graysonriffe/slapdaq-board/README.md

# SlapDAQ Board

This is the KiCad project for the SlapDAQ PCB.
