graysonriffe/slapdaq-board/models/DO3316P.STEP

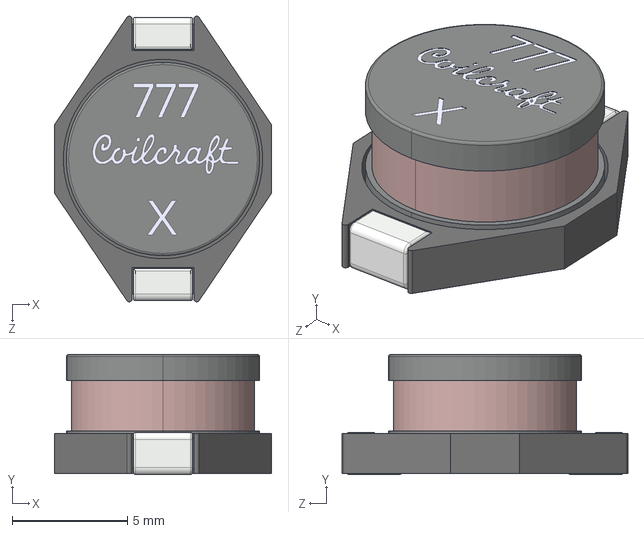
[picture p1: CAD file, 2026-09-25]
models/DO3316P.STEP
9.40 x 5.21 x 12.4 mm
