graysonriffe/slapdaq-board/models/USB4110-GF-A.stp

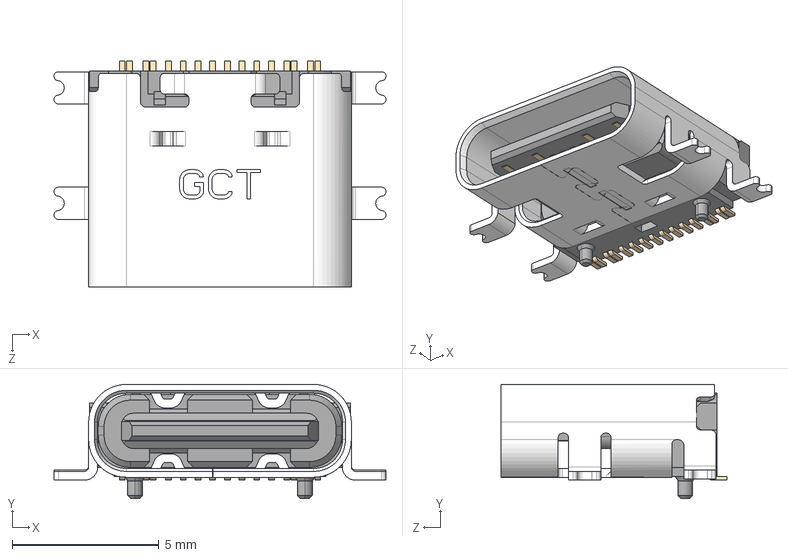
[picture p2: CAD file, 2026-09-25]
models/USB4110-GF-A.stp
11.3 x 3.89 x 7.70 mm
