graysonriffe/slapdaq-board/models/594D_C-case.stp

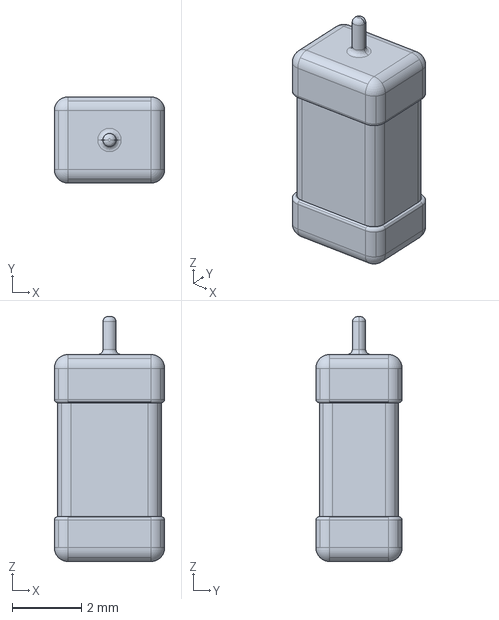
[picture p3: CAD file, 2026-09-25]
models/594D_C-case.stp
3.20 x 2.50 x 7.10 mm
