graysonriffe/slapdaq-board/models/594D_R-case.stp

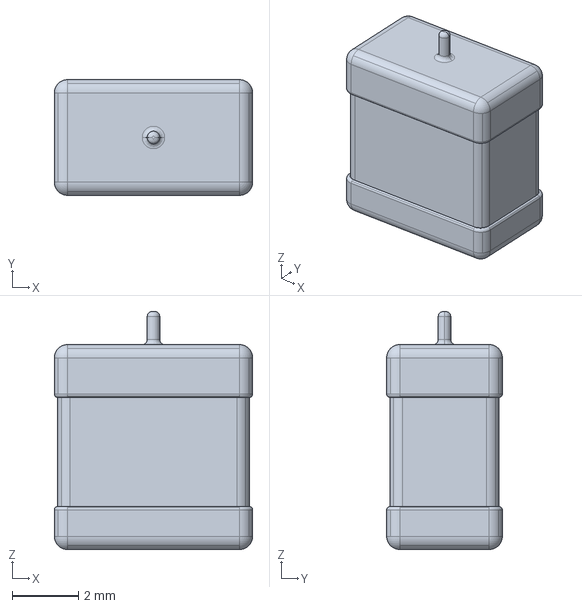
[picture p4: CAD file, 2026-09-25]
models/594D_R-case.stp
6.00 x 3.50 x 7.20 mm
