graysonriffe/slapdaq-board/models/395126010.stp

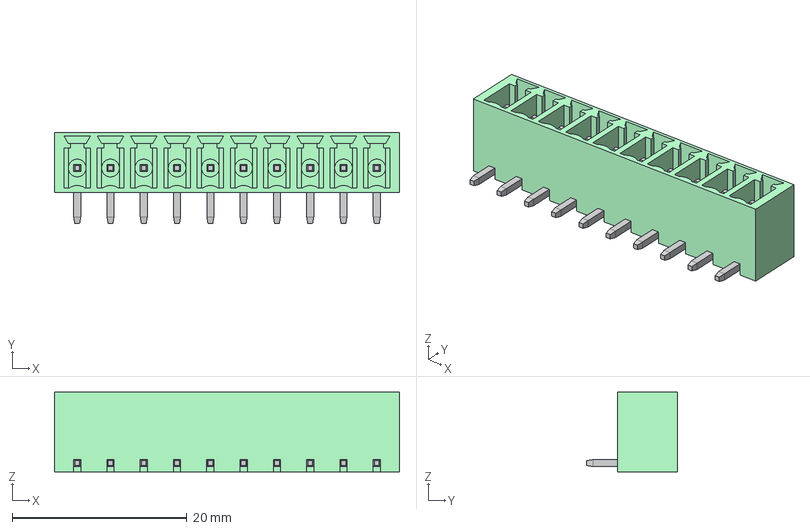
[picture p5: CAD file, 2026-09-25]
models/395126010.stp
39.5 x 10.4 x 9.14 mm
