graysonriffe/slapdaq-board/models/395105010.stp

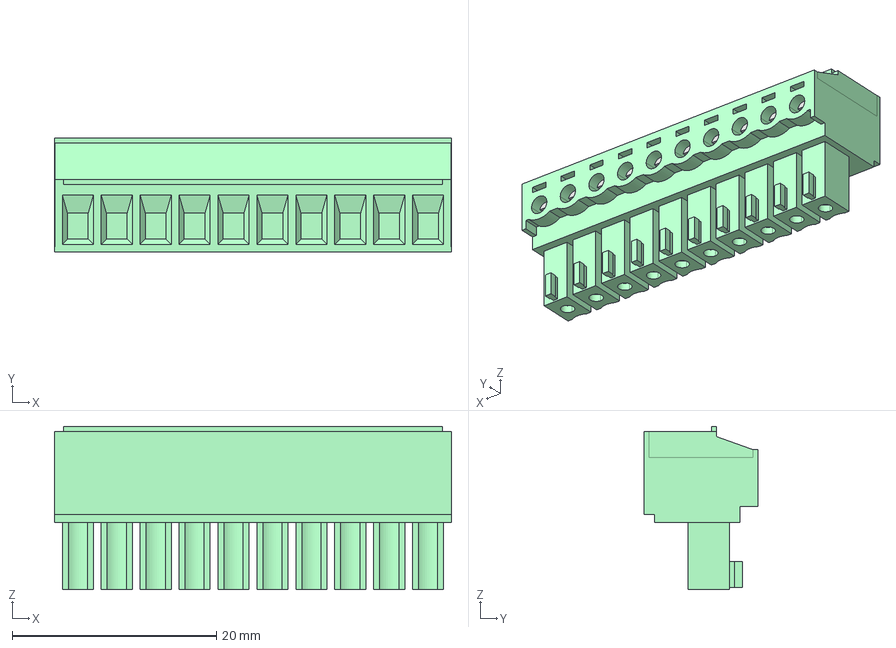
[picture p6: CAD file, 2026-09-25]
models/395105010.stp
38.9 x 11.2 x 16.0 mm
