graysonriffe/slapdaq-board/slapdaq-board.kicad_pcb

## KiCad design slapdaq-board.kicad_pcb (2026-10-12)

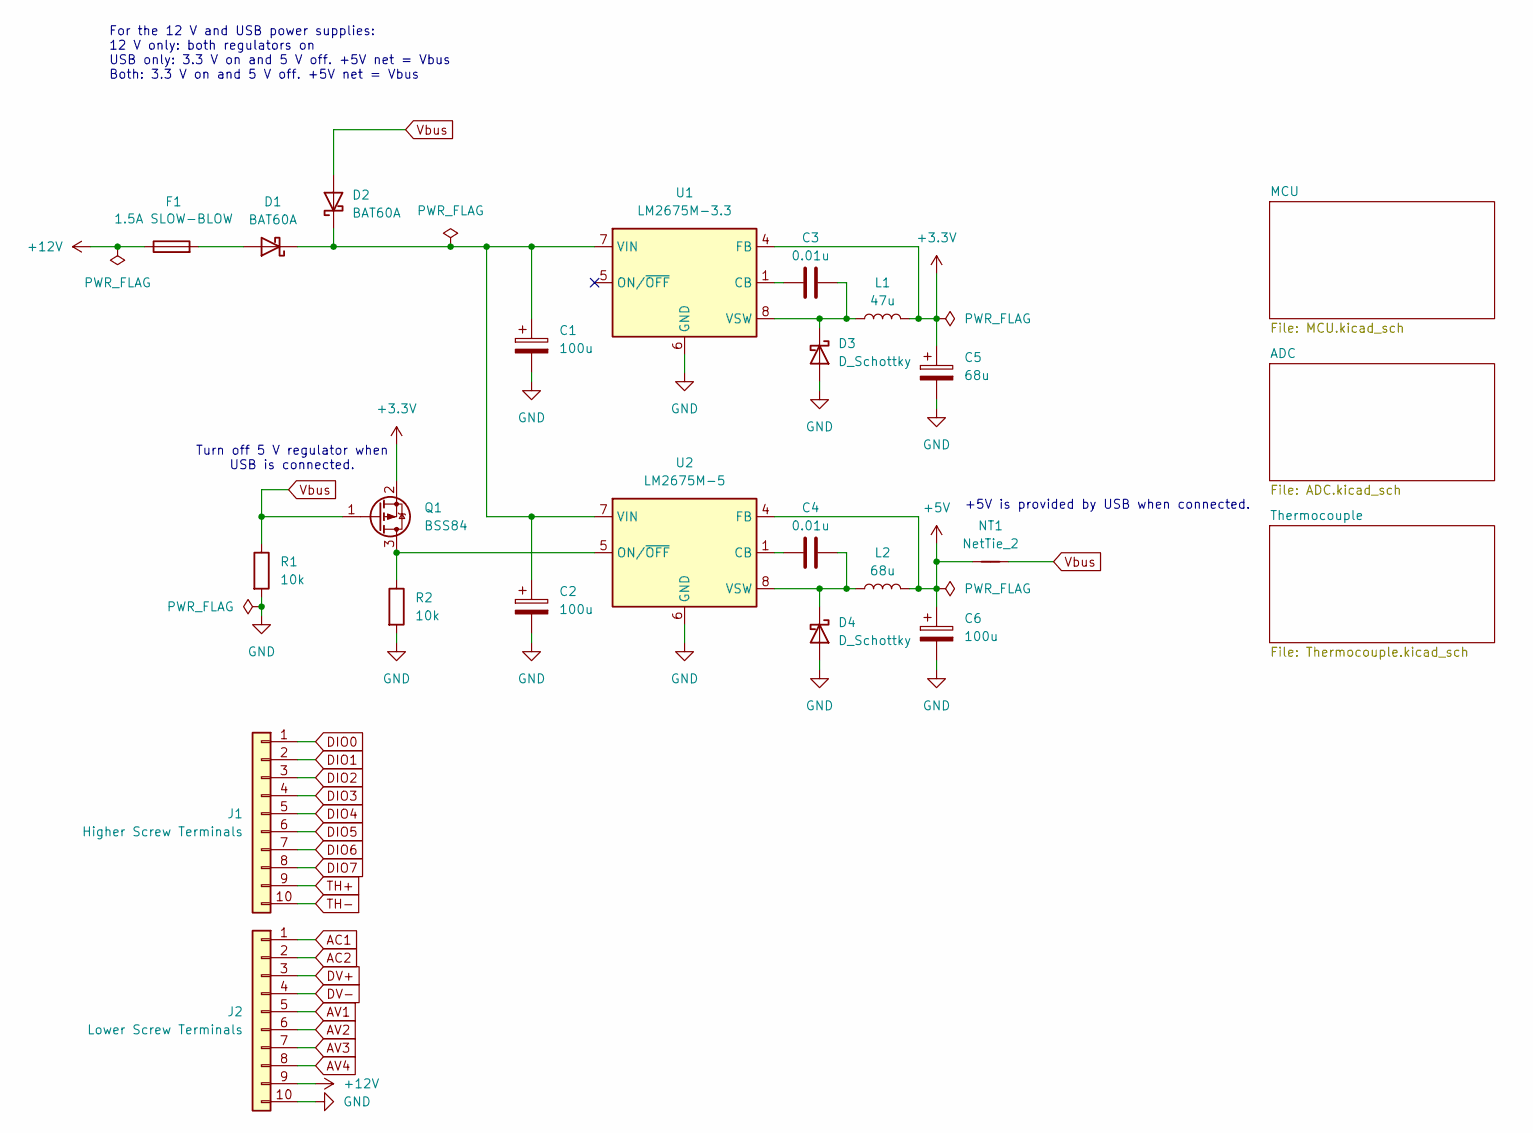
[picture p7: schematic slapdaq-board.kicad_sch, SlapDAQ - Power]

Parts:
C1, C2: 100u; CP_EIA-7260-38_AVX-R_HandSolder; MPN 594D107X9025R2T
C3, C4: 0.01u; C_1206_3216Metric_Pad1.33x1.80mm_HandSolder; MPN GRM31CR73A103KW03L
C5: 68u; CP_EIA-7132-28_AVX-C_HandSolder; MPN 594D686X9010C2T
C6: 100u; CP_EIA-7132-28_AVX-C_HandSolder; MPN 594D107X9016C2T
D1, D2: BAT60A; D_SOD-323; MPN BAT60AE6327HTSA1
D3, D4: D_Schottky; D_SMA_Handsoldering; MPN SK13
F1: 1.5A SLOW-BLOW; Fuse_1206_3216Metric_Pad1.42x1.75mm_HandSolder; MPN SF-1206S150M-2
J1: Higher Screw Terminals; CONN_SD-39512-001_10P_MOL; MPN 39512-6010
J2: Lower Screw Terminals; CONN_SD-39512-001_10P_MOL; MPN 39512-6010
L1: 47u; L_Fastron_PISN_Handsoldering; MPN DO3316P-473MLD
L2: 68u; L_Fastron_PISN_Handsoldering; MPN DO3316P-683MLD
NT1: NetTie_2; NetTie-2_SMD_Pad0.5mm
Q1: BSS84; SOT-23; MPN BSS84AK,215
R1, R2: 10k; R_1206_3216Metric_Pad1.30x1.75mm_HandSolder; MPN RC1206DR-0710KL
U1: LM2675M-3.3; SOIC-8_3.9x4.9mm_P1.27mm; MPN LM2675MX-3.3/NOPB
U2: LM2675M-5; SOIC-8_3.9x4.9mm_P1.27mm; MPN LM2675MX-5.0/NOPB

Connections:
+3.3V: C5.1, L1.2, Q1.2 (S), U1.4 (FB); also elsewhere on the board
+5V: C6.1, L2.2, NT1.1, U2.4 (FB); also elsewhere on the board
+12V: F1.1, J2.9
AC1: J2.1; also elsewhere on the board
AC2: J2.2; also elsewhere on the board
AV1: J2.5; also elsewhere on the board
AV2: J2.6; also elsewhere on the board
AV3: J2.7; also elsewhere on the board
AV4: J2.8; also elsewhere on the board
DIO0: J1.1; also elsewhere on the board
DIO1: J1.2; also elsewhere on the board
DIO2: J1.3; also elsewhere on the board
DIO3: J1.4; also elsewhere on the board
DIO4: J1.5; also elsewhere on the board
DIO5: J1.6; also elsewhere on the board
DIO6: J1.7; also elsewhere on the board
DIO7: J1.8; also elsewhere on the board
DV+: J2.3; also elsewhere on the board
DV-: J2.4; also elsewhere on the board
GND: C1.2, C2.2, C5.2, C6.2, D3.2 (A), D4.2 (A), J2.10, R1.2, R2.2, U1.6 (GND), U2.6 (GND); also elsewhere on the board
unnamed: D1.2 (A), F1.2
unnamed: C1.1, C2.1, D1.1 (K), D2.1 (K), U1.7 (VIN), U2.7 (VIN)
unnamed: C3.2, D3.1 (K), L1.1, U1.8 (VSW)
unnamed: C4.2, D4.1 (K), L2.1, U2.8 (VSW)
unnamed: Q1.3 (D), R2.1, U2.5 (ON/~OFF)
unnamed: C3.1, U1.1 (CB)
unnamed: C4.1, U2.1 (CB)
TH+: J1.9; also elsewhere on the board
TH-: J1.10; also elsewhere on the board
Vbus: D2.2 (A), NT1.2, Q1.1 (G), R1.1; also elsewhere on the board

Notes on the sheet:
Turn off 5 V regulator when USB is connected.
For the 12 V and USB power supplies: 12 V only: both regulators on USB only: 3.3 V on and 5 V off. +5V net = Vbus Both: 3.3 V on and 5 V off. +5V net = Vbus
+5V is provided by USB when connected.

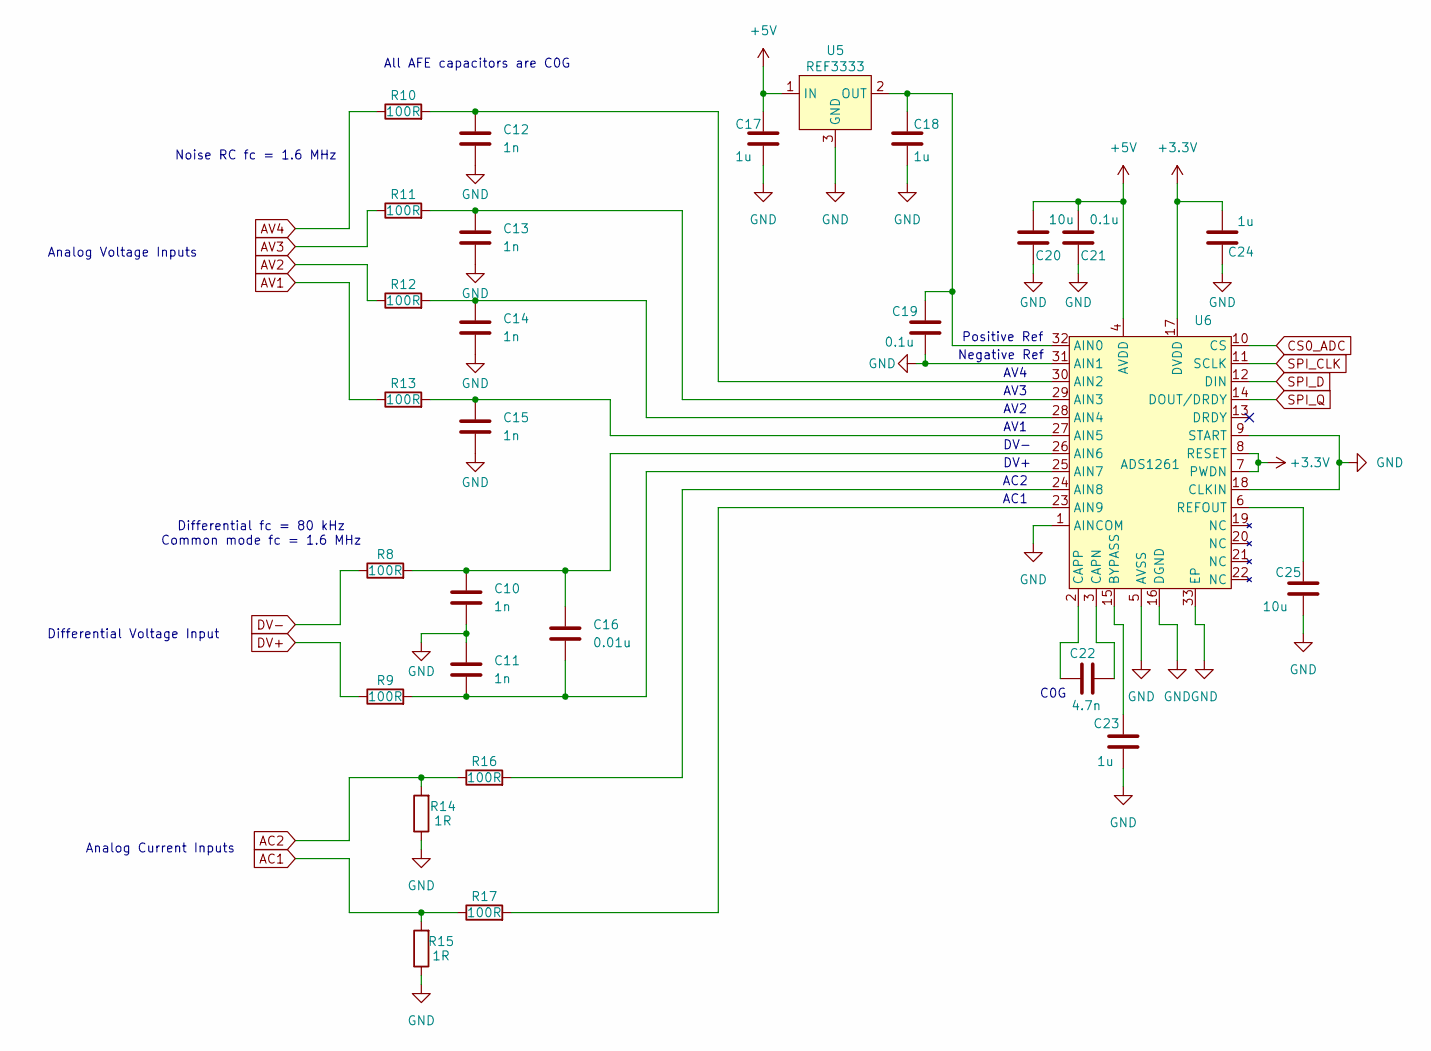
[picture p8: schematic ADC.kicad_sch, SlapDAQ - MCU]

Parts:
C10, C11, C12, C13, C14, C15: 1n; C_1206_3216Metric_Pad1.33x1.80mm_HandSolder; MPN GRM31C5C3A102JWA3L
C16: 0.01u; C_1206_3216Metric_Pad1.33x1.80mm_HandSolder; MPN GRM31C5C2J103JWA3L
C17, C18, C23, C24: 1u; C_1206_3216Metric_Pad1.33x1.80mm_HandSolder; MPN GRM31CR71E105KA01L
C19, C21: 0.1u; C_1206_3216Metric_Pad1.33x1.80mm_HandSolder; MPN GRM31CR72E104KW03L
C20, C25: 10u; C_1206_3216Metric_Pad1.33x1.80mm_HandSolder; MPN GCM31CC71E106KA03K
C22: 4.7n; C_1206_3216Metric_Pad1.33x1.80mm_HandSolder; MPN GCM3195C2A472FA16D
R8, R9, R10, R11, R12, R13, R16, R17: 100R; R_1206_3216Metric_Pad1.30x1.75mm_HandSolder; MPN RC1206DR-07100RL
R14, R15: 1R; R_1206_3216Metric_Pad1.30x1.75mm_HandSolder; MPN AC1206FR-071RL
U5: REF3333; SOT-23; MPN REF3333AIDBZR
U6: ADS1261; QFN-32-1EP_5x5mm_P0.5mm_EP3.45x3.45mm_ThermalVias; MPN ADS1261IRHBT

Connections:
+3.3V: C24.2, U6.7 (PWDN), U6.8 (RESET), U6.17 (DVDD); also elsewhere on the board
+5V: C17.1, C20.2, C21.2, U5.1 (IN), U6.4 (AVDD); also elsewhere on the board
AC1: R15.2, R17.1; also elsewhere on the board
AC2: R14.2, R16.1; also elsewhere on the board
AV1: R13.1; also elsewhere on the board
AV2: R12.1; also elsewhere on the board
AV3: R11.1; also elsewhere on the board
AV4: R10.1; also elsewhere on the board
CS0_ADC: U6.10 (CS); also elsewhere on the board
DV+: R9.1; also elsewhere on the board
DV-: R8.1; also elsewhere on the board
GND: C10.2, C11.1, C12.2, C13.2, C14.2, C15.2, C17.2, C18.2, C19.2, C20.1, C21.1, C23.2, C24.1, C25.2, R14.1, R15.1, U5.3 (GND), U6.1 (AINCOM), U6.5 (AVSS), U6.9 (START), U6.16 (DGND), U6.18 (CLKIN), U6.31 (AIN1), U6.33 (EP); also elsewhere on the board
unnamed: C18.1, C19.1, U5.2 (OUT), U6.32 (AIN0)
unnamed: C12.1, R10.2, U6.30 (AIN2)
unnamed: C13.1, R11.2, U6.29 (AIN3)
unnamed: C14.1, R12.2, U6.28 (AIN4)
unnamed: C15.1, R13.2, U6.27 (AIN5)
unnamed: C10.1, C16.1, R8.2, U6.26 (AIN6)
unnamed: C11.2, C16.2, R9.2, U6.25 (AIN7)
unnamed: R16.2, U6.24 (AIN8)
unnamed: R17.2, U6.23 (AIN9)
unnamed: C23.1, U6.15 (BYPASS)
unnamed: C22.2, U6.3 (CAPN)
unnamed: C22.1, U6.2 (CAPP)
unnamed: C25.1, U6.6 (REFOUT)
SPI_CLK: U6.11 (SCLK); also elsewhere on the board
SPI_D: U6.12 (DIN); also elsewhere on the board
SPI_Q: U6.14 (DOUT/DRDY); also elsewhere on the board

Notes on the sheet:
AC1
Positive Ref
Negative Ref
Noise RC fc = 1.6 MHz
AV4
Differential fc = 80 kHz Common mode fc = 1.6 MHz
Analog Current Inputs
AV1
AC2
Analog Voltage Inputs
AV3
All AFE capacitors are C0G
DV+
DV-
Differential Voltage Input
AV2
C0G

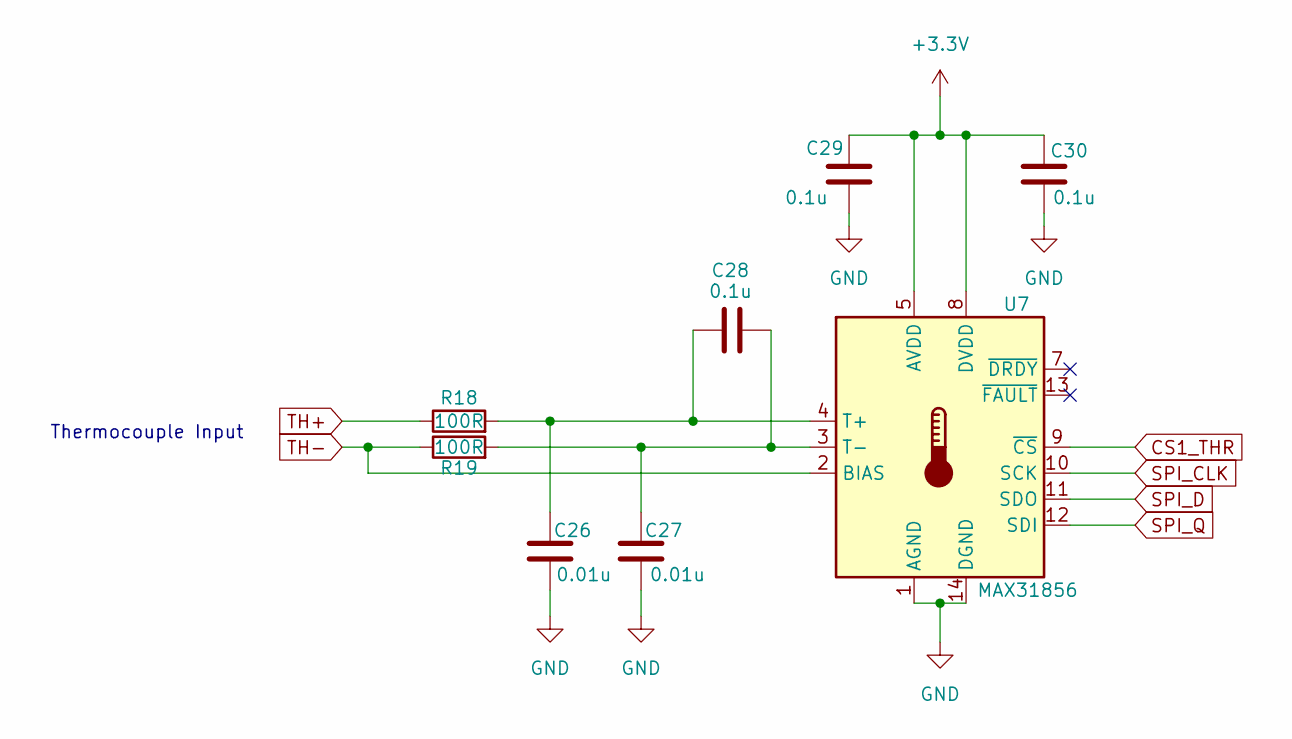
[picture p9: schematic Thermocouple.kicad_sch, SlapDAQ - Thermocouple]

Parts:
C26, C27: 0.01u; C_1206_3216Metric_Pad1.33x1.80mm_HandSolder; MPN GRM31CR73A103KW03L
C28, C29, C30: 0.1u; C_1206_3216Metric_Pad1.33x1.80mm_HandSolder; MPN GRM31CR72E104KW03L
R18, R19: 100R; R_1206_3216Metric_Pad1.30x1.75mm_HandSolder; MPN RC1206DR-07100RL
U7: MAX31856; TSSOP-14_4.4x5mm_P0.65mm; MPN MAX31856MUD+

Connections:
+3.3V: C29.1, C30.1, U7.5 (AVDD), U7.8 (DVDD); also elsewhere on the board
CS1_THR: U7.9 (~CS); also elsewhere on the board
GND: C26.2, C27.2, C29.2, C30.2, U7.1 (AGND), U7.14 (DGND); also elsewhere on the board
unnamed: C26.1, C28.1, R18.2, U7.4 (T+)
unnamed: C27.1, C28.2, R19.2, U7.3 (T-)
SPI_CLK: U7.10 (SCK); also elsewhere on the board
SPI_D: U7.11 (SDO); also elsewhere on the board
SPI_Q: U7.12 (SDI); also elsewhere on the board
TH+: R18.1; also elsewhere on the board
TH-: R19.1, U7.2 (BIAS); also elsewhere on the board

Notes on the sheet:
Thermocouple Input

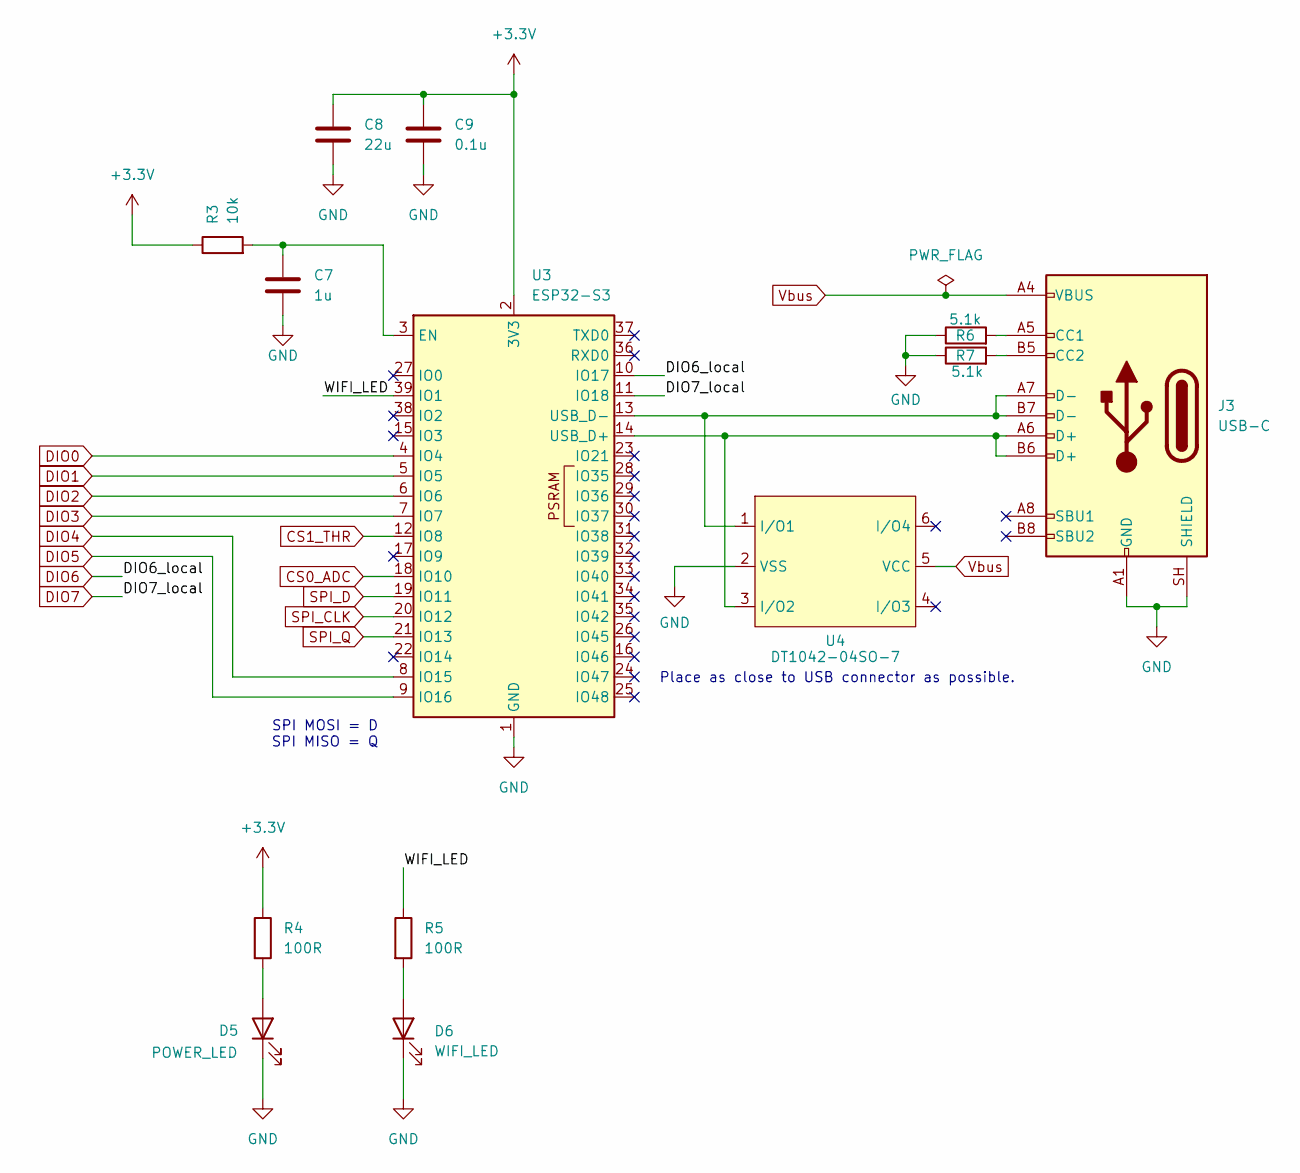
[picture p10: schematic MCU.kicad_sch, SlapDAQ - MCU]

Parts:
C7: 1u; C_1206_3216Metric_Pad1.33x1.80mm_HandSolder; MPN GRM31CR71E105KA01L
C8: 22u; C_1206_3216Metric_Pad1.33x1.80mm_HandSolder; MPN GCM31CR71A226KE02L
C9: 0.1u; C_1206_3216Metric_Pad1.33x1.80mm_HandSolder; MPN GRM31CR72E104KW03L
D5: POWER_LED; LED_D5.0mm_Horizontal_O1.27mm_Z3.0mm; MPN WP7113ID
D6: WIFI_LED; LED_D5.0mm_Horizontal_O1.27mm_Z3.0mm; MPN WP7113YD
J3: USB-C; USB_C_Receptacle_GCT_USB4110; MPN USB4110-GF-A
R3: 10k; R_1206_3216Metric_Pad1.30x1.75mm_HandSolder; MPN RC1206DR-0710KL
R4, R5: 100R; R_1206_3216Metric_Pad1.30x1.75mm_HandSolder; MPN RC1206DR-07100RL
R6, R7: 5.1k; R_1206_3216Metric_Pad1.30x1.75mm_HandSolder; MPN AC1206FR-075K1L
U3: ESP32-S3; ESP32-S3-WROOM-1; MPN ESP32-S3-WROOM-1-N16R8
U4: DT1042-04SO-7; SOT-23-6; MPN DT1042-04SOQ-7

Connections:
+3.3V: C8.2, C9.2, R3.1, R4.1, U3.2 (3V3); also elsewhere on the board
/MCU/WIFI_LED: R5.1, U3.39 (IO1)
CS0_ADC: U3.18 (IO10); also elsewhere on the board
CS1_THR: U3.12 (IO8); also elsewhere on the board
DIO0: U3.4 (IO4); also elsewhere on the board
DIO1: U3.5 (IO5); also elsewhere on the board
DIO2: U3.6 (IO6); also elsewhere on the board
DIO3: U3.7 (IO7); also elsewhere on the board
DIO4: U3.8 (IO15); also elsewhere on the board
DIO5: U3.9 (IO16); also elsewhere on the board
DIO6: U3.10 (IO17); also elsewhere on the board
DIO7: U3.11 (IO18); also elsewhere on the board
GND: C7.2, C8.1, C9.1, D5.1 (K), D6.1 (K), J3.A1 (GND), J3.A12 (GND), J3.B1 (GND), J3.B12 (GND), J3.SH (SHIELD), R6.1, R7.1, U3.1 (GND), U3.40 (GND), U3.41 (GND), U4.2 (VSS); also elsewhere on the board
unnamed: D5.2 (A), R4.2
unnamed: D6.2 (A), R5.2
unnamed: J3.A5 (CC1), R6.2
unnamed: J3.B5 (CC2), R7.2
unnamed: C7.1, R3.2, U3.3 (EN)
unnamed: J3.A6 (D+), J3.B6 (D+), U3.14 (USB_D+), U4.3 (I/O2)
unnamed: J3.A7 (D-), J3.B7 (D-), U3.13 (USB_D-), U4.1 (I/O1)
SPI_CLK: U3.20 (IO12); also elsewhere on the board
SPI_D: U3.19 (IO11); also elsewhere on the board
SPI_Q: U3.21 (IO13); also elsewhere on the board
Vbus: J3.A4 (VBUS), J3.A9 (VBUS), J3.B4 (VBUS), J3.B9 (VBUS), U4.5 (VCC); also elsewhere on the board

Notes on the sheet:
SPI MOSI = D SPI MISO = Q
Place as close to USB connector as possible.

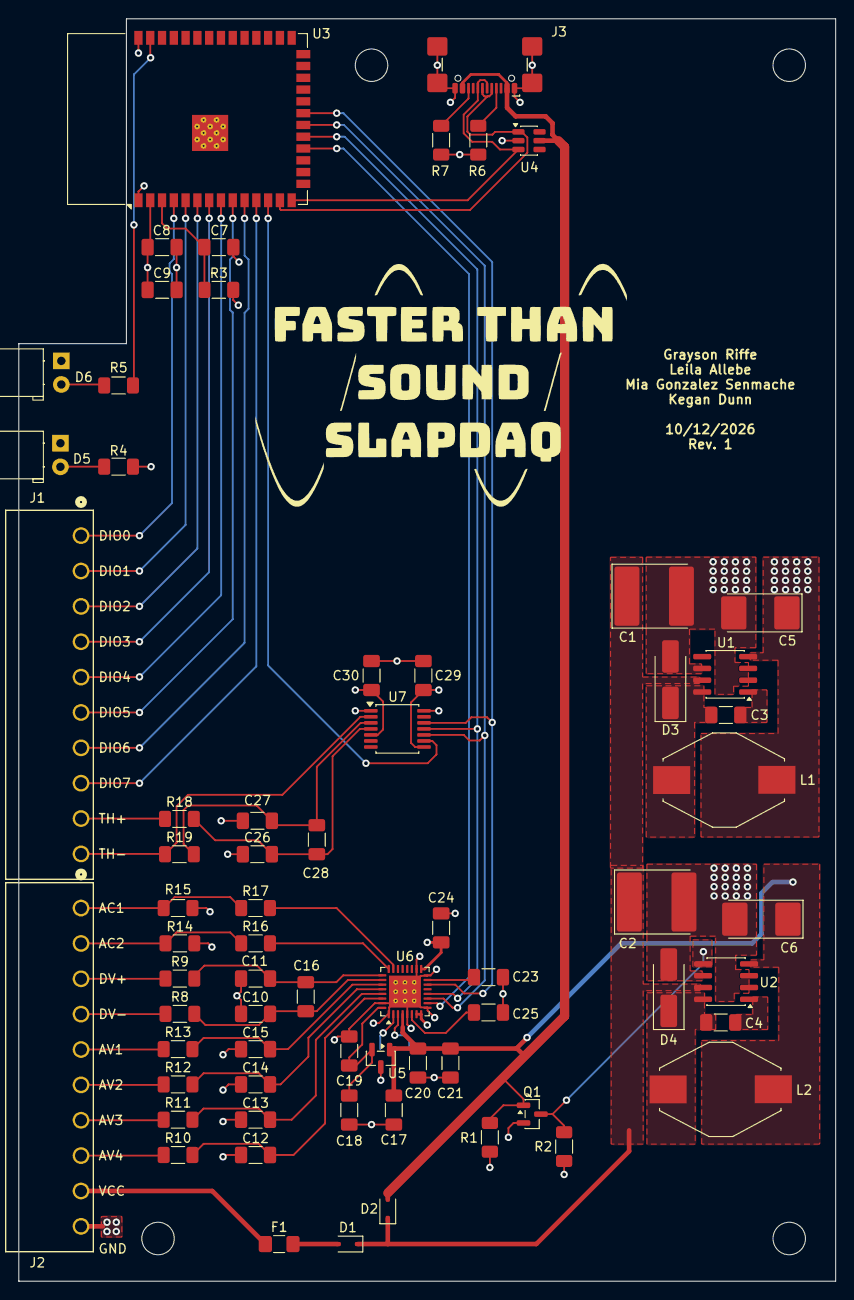
[picture p11: board slapdaq-board.kicad_pcb from above]

Board: 4 copper layers, 88.0 x 136.0 mm, 70 parts (1 on the bottom side), 58 nets.
