graysonriffe/slapdaq-board/(commit log)

2026-09-04 Add base KiCad project
    [Analog_Voltage_Inputs.kicad_sch, ESP32_Digital_IO.kicad_sch, capstoneKicad.kicad_pcb, capstoneKicad.kicad_sch]
2026-09-07 added remaining pages. BOM and refinement is all thats left
    [Current_Inputs.kicad_sch, Differential_Voltage_Input.kicad_sch, ESP32_Digital_IO.kicad_sch, Thermocouple_Input.kicad_sch]
2026-09-08 Added a few comments in blue text
    [Analog_Voltage_Inputs.kicad_sch, Current_Inputs.kicad_sch, ESP32_Digital_IO.kicad_sch, capstoneKicad.kicad_sch]
2026-09-09 finished schematic draft 1
    [Analog_Voltage_Inputs.kicad_sch, Current_Inputs.kicad_sch, Differential_Voltage_Input.kicad_sch, ESP32_Digital_IO.kicad_sch, SlapDAQ_BOM_Draft1.csv, Thermocouple_Input.kicad_sch, capstoneKicad.kicad_sch]
2026-09-09 Fixed some issues and renamed project
    [Analog_Voltage_Inputs.kicad_sch, Current_Inputs.kicad_sch, Differential_Voltage_Input.kicad_sch, ESP32_Digital_IO.kicad_sch, SlapDAQ_BOM_Draft1.csv, Thermocouple_Input.kicad_sch, capstoneKicad.kicad_pcb, slapdaq-board.kicad_pcb]
2026-09-11 "combined analog voltage and differential voltage sheets
    [Analog_Voltage_Inputs.kicad_sch, ESP32_Digital_IO.kicad_sch, slapdaq-board.kicad_sch]
2026-09-11 Grayson changes 9/11/26
    [Differential_Voltage_Input.kicad_sch, ESP32_Digital_IO.kicad_sch, Thermocouple_Input.kicad_sch, slapdaq-board.kicad_sch]
2026-09-13 9/13/2026 schematic work
    [ADC.kicad_sch, Analog_Voltage_Inputs.kicad_sch, Current_Inputs.kicad_sch, ESP32_Digital_IO.kicad_sch, MCU_DIO.kicad_sch, Thermocouple.kicad_sch, slapdaq-board.kicad_sch]
2026-09-14 changed sheet names
    [MCU_DIO.kicad_sch, Thermocouple.kicad_sch, slapdaq-board.kicad_sch]
2026-09-14 changed net labels to global labels
    [ADC.kicad_sch, MCU_DIO.kicad_sch, Thermocouple.kicad_sch]
2026-09-16 added gnd to inputs
    [ADC.kicad_sch, MCU_DIO.kicad_sch, Thermocouple.kicad_sch]
2026-09-18 9/18/2026 schematic work
    [ADC.kicad_sch, MCU.kicad_sch, Thermocouple.kicad_sch, slapdaq-board.kicad_sch]
2026-09-18 removed grounds from inputs
    [ADC.kicad_sch, MCU.kicad_sch, Thermocouple.kicad_sch, slapdaq-board.kicad_sch]
2026-09-21 9/20/2026 schematic work
    [ADC.kicad_sch, MCU.kicad_sch, Thermocouple.kicad_sch, slapdaq-board.kicad_sch]
2026-09-23 Prepare PCB
    [slapdaq-board.kicad_pcb]
2026-09-23 started moving components around on pcb
    [slapdaq-board.kicad_pcb]
2026-09-23 pcb work
    [slapdaq-board.kicad_pcb]
2026-09-24 did some traces
    [slapdaq-board.kicad_pcb]
2026-09-25 did fills for voltages
    [slapdaq-board.kicad_pcb]
2026-09-25 Add screw terminals
    [395105010.stp, 395126010.stp, ADC.kicad_sch, MCU.kicad_sch, Thermocouple.kicad_sch, slapdaq-board.kicad_pcb, slapdaq-board.kicad_sch]
2026-09-25 Add 3D models and rearrange pins
    [594D_C-case.stp, 594D_R-case.stp, ADC.kicad_sch, DO3316P.STEP, MCU.kicad_sch, USB4110-GF-A.stp, slapdaq-board.kicad_pcb, slapdaq-board.kicad_sch]
2026-09-28 pcb trace work
    [slapdaq-board.kicad_pcb]
2026-09-30 implemented PCB feedback from meeting
    [slapdaq-board.kicad_pcb]
2026-09-30 moved usb
    [slapdaq-board.kicad_pcb]
2026-10-01 moved LEDs over a little, did a sample edge cut, and some traces that i think could work
    [slapdaq-board.kicad_pcb]
2026-10-02 Finalize board outline
    [slapdaq-board.kicad_pcb]
2026-10-02 Add ground and power planes
    [slapdaq-board.kicad_pcb]
2026-10-05 made traces bigger and had to move mounting hole a little down to accomodate that
    [slapdaq-board.kicad_pcb]
2026-10-07 added zone around ground vias and added vias for 3.3V
    [slapdaq-board.kicad_pcb]
2026-10-07 added logo to silkscreen
    [slapdaq-board.kicad_pcb]
2026-10-12 Finish rev. 1 PCB
